radioman30/Radioberry_Pico2/PINI_SI_FIRMWARE.md

# Radioberry RX pe RP2350-PiZero — pini și firmware (stare la 2 oct 2026)

Firmware: `rx_audio` cu **gateware PIO 75.2** (RagchewBerry/WP3DN, citit cu PIO + DMA, 4 linii de date) — 3 oct 2026.
Versiunea veche, pe 8 linii (gateware 73.3): `release/rx_audio_2026-10-03_5730f61.uf2`. Detalii: `PROTOCOL.md` §7.
Fișierul gata de scris pe placă: `release/rx_audio_2026-10-02_e40b5ea.uf2` (local, nu e pe GitHub —
conține gateware-ul PA3GSB/Hermes-Lite2, binar terț).

---

## 1. Cum scrii firmware-ul pe placă

**Varianta simplă (fără programe):**
1. Ține apăsat butonul **BOOT** de pe PiZero și bagă cablul USB în portul USB principal.
2. Dă drumul butonului. Apare un disc nou, **RP2350**.
3. Copiază fișierul `.uf2` pe disc. Placa se repornește singură cu noul firmware.

**Din sursă:** `powershell -File tools\build_rx_audio.ps1 -Flash` (compilează și scrie; găsește singur portul).

După flash, placa apare în Windows ca **port COM12** + **„Microphone (Radioberry RX audio)”**.
Setările salvate (frecvență, mod, filtre, volum, benzi) rămân după reflash cu aceeași versiune.

> Dacă după BOOT Windows nu mai deschide portul COM („device not functioning”): Device Manager →
> șterge dispozitivul USB al plăcii și reconectează (vezi §6).

---

## 2. Header-ul de 40 de pini — ce e legat unde

Radioberry e înfipt direct în header. „Radioberry” = pin folosit de placa radio, nu legi nimic acolo.
GP = numărul GPIO al RP2350 (pe PiZero NU e mereu egal cu BCM).

| Pin | BCM | GP | Folosit de | Ce legi tu |
|---|---|---|---|---|
| 1 | 3V3 | — | alimentare | PCM5102A **VIN**, OLED **VCC** |
| 2, 4 | 5V | — | alimentare Radioberry | — |
| 3 | 2 | **2** | I2C SDA | OLED **SDA** + HAT pin 3 |
| 5 | 3 | **3** | I2C SCL | OLED **SCL** + HAT pin 5 |
| 6, 9, 14, 20, 25, 30, 34, 39 | GND | — | masă | GND PCM5102A, OLED, encoder, butoane, condensator |
| 7 | 4 | **14** | liber cu WM8960 — rezervat TX_CLK (gateware PIO) | (doar rezerva PCM5102A **DIN**) |
| 8 | 14 | **4** | I2S BCLK (intrare, codecul e master) | HAT pin 12 |
| 10 | 15 | **5** | I2S LRCLK (intrare) | HAT pin 35 |
| 11 | 17 | 17 | ieșire FPGA (`pi_cwl`) | **NU LEGA** |
| 12 | 18 | 18 | Radioberry: date RX D0 (PIO) | — |
| 13 | 27 | 27 | Radioberry: nCONFIG | — |
| 15 | 22 | 22 | Radioberry: CONF_DONE | — |
| 16 | 23 | 23 | fost date RX bit 7 — în FPGA doar pull-up slab (test `u`, 21 oct) | WM8960 **ADCDAT** (HAT pin 38) |
| 17 | 3V3 | — | alimentare | ⚠️ chiar lângă pinul 18 — atenție la lipituri |
| **18** | 24 | **24** | Radioberry: DCLK (doar la pornire) | **rețeaua de butoane** prin 470 Ω (§3) |
| 19 | 10 | 11 | Radioberry: SPI MOSI | — |
| 21 | 9 | 12 | Radioberry: SPI MISO | — |
| 22 | 25 | 25 | Radioberry: RDY | — |
| 23 | 11 | 10 | Radioberry: SPI SCLK | — |
| 24 | 8 | 8 | Radioberry: SPI CE0 | — |
| 26 | 7 | 7 | Radioberry: SPI CE1 | — |
| 27 | 0 | **0** | encoder | encoder **A** (CLK) |
| 28 | 1 | **1** | encoder | encoder **B** (DT) |
| 29 | 5 | 15 | Radioberry: TX_DATA (rezervat) | — |
| 31 | 6 | 6 | Radioberry: ceas RX | — |
| 32 | 12 | 9 | Radioberry: TX_RDY (rezervat) | — |
| 33 | 13 | 13 | Radioberry: DATA0 (doar la pornire) | — |
| 35 | 19 | 19 | Radioberry: date RX D1 (PIO) | — |
| 36 | 16 | 16 | fost date RX bit 3 — în FPGA doar pull-up slab (test `u`, 21 oct) | WM8960 **DACDAT** (HAT pin 40) |
| 37 | 26 | 26 | Radioberry: nSTATUS | — |
| 38 | 20 | 20 | Radioberry: date RX D2 (PIO) | — |
| 40 | 21 | 21 | Radioberry: date RX D3 (PIO) | — |

**PCM5102A:** SCK → GND, XSMT → 3V3, FLT/DEMP/FMT → GND. Căștile în mufa modulului.
**Encoder:** comunul la GND. Pinul „+” al modulului **nelegat** (are pull-up-uri de 10 kΩ care încurcă butoanele).

---

## 3. Butoanele — toate pe pinul 18 (GP24)

Pe header nu există pin analogic, așa că butoanele se recunosc după timpul de descărcare al unui
condensator prin rezistența fiecăruia.

```
 pin 18 (GP24) ──[ 470 Ω ]──┬──────────┬──────────┬──────────┐
                            │          │          │          │
                       tantal 1 µF  encoder SW    MOD       BANDA
                       (+ spre nod)    │          │          │
                            │          │       [1 kΩ]    [2,2 kΩ]
                            │          │          │          │
 GND ───────────────────────┴──────────┴──────────┴──────────┘
```

| Buton | Rezistor | Funcție | Timp măsurat pe banc |
|---|---|---|---|
| encoder SW | direct | meniu: parametrul următor; lung = înapoi la FRECV | 0 µs |
| MOD | 1 kΩ | USB → LSB → CW → AM → FM | 600–860 µs |
| BANDA | 2,2 kΩ | scurt = banda următoare, lung = banda anterioară | 2275–3050 µs |
| **PTT (TX)** | 4,7 kΩ | emisie cât e ținut apăsat | 20–26 ms (fereastra PTT: 5–40 ms) |
| (PAS) | 10 kΩ | nefolosit (fereastra lui e acum PTT) | — |

- **470 Ω e obligatoriu**: izolează condensatorul de DCLK la încărcarea FPGA-ului.
- **Modulele de butoane cu pull-up de 10 kΩ** (rezistor spre „+”): rezistorul se scoate sau „+” rămâne nelegat.
- Placa detectează singură rețeaua; pe ecran apare **„RC”** jos-dreapta. Fără ea, pinul 18 e buton simplu.
- Nu ține niciun buton apăsat la pornire.
- Verificare pe USB: `k` (stare + ultimul timp măsurat), `kd` (diagnostic condensator).

---

## 4. Istoricul modificărilor de pini

| Data | Ce s-a schimbat | De ce |
|---|---|---|
| 1 oct | PCM5102A mutat pe **GP4 / GP5 / GP14** (pinii 8 / 10 / 7) | primii pini aleși (GP16 / GP23) sunt linii de date ale Radioberry |
| 1 oct | encoder A/B pe **GP0 / GP1** (pinii 27 / 28), SW pe **GP24** (pinul 18) | singurii pini liberi; DCLK e liber după încărcarea FPGA-ului |
| 1 oct | butonul **BOOT** = banda următoare | header-ul nu mai avea pini |
| 2 oct | butoane **MOD + BANDA pe pinul 18** prin rețea RC (470 Ω, 1 µF, 1 kΩ, 2,2 kΩ); firul SW mutat pe nod | mai multe comenzi fără pini noi |
| 2 oct | scos pull-up-ul de 10 kΩ de pe modulele de butoane | reîncărca condensatorul, toate butoanele păreau „encoder” |
| 2 oct | butonul **BOOT nu mai are funcție** (doar pentru flash) | la cererea ta |
| 2 oct | USB: PID **2E8A:10F1**, portul devine **COM12** (era COM10) | PID-ul vechi (000F) era același cu modul BOOT → Windows încurca driverele |
| 3 oct | **gateware PIO 75.2**: date RX doar pe pinii 12/35/38/40 (GP18–21); pinii 16 și 36 (GP23/GP16) nu mai sunt date | gateware-ul RagchewBerry (WP3DN); cablajul tău rămâne neschimbat |

---

## 5. Ce face firmware-ul

- **Recepție:** USB, LSB, CW, AM, **FM** (bandă îngustă), **SAM** (AM sincron), 10 kHz – 30 MHz, IQ 48 kHz de la FPGA.
- **Squelch** (meniu SQL, oprit sau **+1…+40 dB peste zgomot**): taie căștile până apare semnal; USB-ul rămâne neatins.
  Zgomotul se estimează singur, deci pragul nu mai trebuie refăcut când schimbi câștigul sau banda (de la 3 oct).
  Bun de pornit: +6…+10 dB. Starea (`s`) arată și zgomotul estimat.
  Pe ecran „Q” jos-dreapta, inversat când e închis.
- **Reducere de zgomot** (meniu NR, oprit / 1 / 2 / 3), pe ecran „N”. Simulat: +9 dB (NR1) … +14,5 dB (NR3) SNR.
- **SAM:** PLL pe purtătoare (prinde ±300 Hz în ~20 ms); la fading distorsiunea scade de la -12 dB la -32 dB (simulat).
- Meniul encoderului: FRECV → PAS → MOD → FILTRU → BANDA → VOL → GAIN → **SQL → NR → CAL → DRIVE → MIC → MIC SRC**.
- **Filtre:** SSB 1,8 / 2,0 / 2,5 / 2,7 kHz · CW 250 / 500 / 1000 Hz · AM 6 / 8 kHz · FM 8 / 11 kHz.
- **Benzi** (cu memorie): 160, 80, 60, 49 (AM), 40, 41 (AM), 31 (AM), 30, 20, 17, 15, 12, **CB** (FM), 10 m.
- **Ecran:** frecvență, bandă, mod, S-metru, spectru ±24 kHz, waterfall, meniu jos (pas, volum, câștig, filtru).
- **Setările** se salvează singure în flash la 5 s după ultima schimbare.
- **USB:**
  - **COM12** — comenzi text + **CAT Kenwood TS-2000** (WSJT-X, fldigi, Omni-Rig/HDSDR: 115200, DTR High, PTT None);
  - **microfon „Radioberry RX audio”** — audio demodulat 48 kHz, nivel fix (fără volumul căștilor);
  - **IQ brut** — `python tools/iq_record.py -t 60 -o iq_rec` → WAV pentru HDSDR / SDR# / SDR++.

**Comenzi pe COM12:** `s` stare · `f<Hz>` frecvență · `m<0-5>` mod (5 = SAM) · `v<0-100>` volum · `g<-12..48>` câștig ·
`w<Hz>` filtru · `l<dB>` squelch peste zgomot, 1–40 (`l0` oprit) · `n<0-3>` NR · `c` / `c<ppb>` calibrare · `k` / `kd` butoane · `x` inversează IQ (doar pentru teste; implicit corect = neinversat, verificat cu FT8) · `q1`/`q0` flux IQ · `z<start,stop,pas kHz>` baleiaj.

---

## 6. Probleme cunoscute și soluții

| Simptom | Cauză | Soluție |
|---|---|---|
| COM-ul există dar nu răspunde („device not functioning”) | Windows a legat driverul greșit după BOOT | Device Manager → șterge dispozitivul plăcii → reconectează |
| Toate butoanele fac ce face encoderul | lipsește condensatorul / 470 Ω, sau un pull-up 10 kΩ pe nod | §3; verifică cu `kd` (bun: urcare zeci de ms) |
| Placa nu apare deloc pe USB | scurt la pinul 17 (3V3) lângă 18, tantal invers | verifică lipiturile de lângă pinul 18 |
| Frecvența din WSJT-X nu se schimbă | portul e ocupat de alt program (iq_record, alt terminal) | un singur program pe COM12 odată |

---

## 7. WM8960 Audio HAT — FUNCȚIONAL (21 oct 2026)

**Ce merge:** codec master (PLL din cristalul de 24 MHz → 12,288 MHz; BCLK 1,536 MHz, LRCLK 48 kHz), RP2350 slave
cu program PIO duplex propriu (`wm_pio_start()` în rx_audio.ino) + 2 DMA în inel fără IRQ; difuzoare, căști și
microfoane verificate (48 000 cadre/s, înregistrare microfon fără date pierdute). Driverul: `wm8960.cpp/.h`.
Setările (căști, difuzor, PGA, boost) se salvează în flash (magic RBS4; setările RBS3 se migrează).

**Capcane găsite la punere în funcțiune:**
- Biblioteca I2S din core nu poate fi slave cu intrare aici: cere DIN = BCLK − 1 = GP3 (SCL-ul OLED).
- **SDA blocat după fiecare flash:** Pico se resetează, HAT-ul (5V din header) nu; WM8960 rămâne ținând SDA jos
  → I2C mort, OLED stins. Rezolvat cu `i2c_bus_recover()` la pornire (impulsuri SCL + STOP).
- Pinii I2S ai HAT-ului legați pin-la-pin (ca la un HAT înfipt) cad pe D0–D3 ale Radioberry → IQ stricat.
- **22 oct — I2C instabil intermitent** (SDA ținut la masă de un cip extern, display înghețat, scrieri WM8960 pierdute,
  apărea și dispărea singur; inclusiv cu firmware-ul care mergea pe 21 oct ⇒ hardware). **Rezolvat de user cu un al doilea
  fir de GND între HAT și PiZero + rezistențe pull-up pe SCL/SDA.** Verificat: 16/16 scanări curate, inclusiv după repornire.
  Comanda `o` = model de test pe OLED 15 s (chenar + rândurile 0/2/4/59/61/63).
- Microfonul cu boost +29 dB + PGA +12 dB prinde tot din cameră (fond −26…−33 dBFS); pentru voce: boost +13 dB.
- Comenzile care blocau bucla principală 50 ms dădeau pârâit (rezervă DAC 16 ms) → acum rezervă 62 ms și
  așteptări care pompează audio în continuare.

> **Actualizare 21 oct 2026 (placa a sosit):** cu gateware-ul PIO 75.2 GP16/GP23 sunt libere, deci **DACDAT → GP16
> (pin 36)** și **ADCDAT → GP23 (pin 16)**; varianta GPIO28/USB-C de mai jos e abandonată. GP14 (pin 7) se eliberează
> pentru TX (BCM4 = TX_CLK în gateware-ul PIO). BCK GP4 / LRCK GP5 / I2C GP2-3 rămân. Test `u` (rx_audio, Radioberry
> activ): ambele pini rămân 1 și cu pull-down-ul RP2350, dar trași jos 2 µs la 2 mA cobor și revin în 100–200 ns ⇒
> **pull-up slab (~25 kΩ) al FPGA pe pinii nefolosiți, nu ieșire**. Recomandat 330 Ω în serie pe ambele linii.

Sursă: [wiki Waveshare](https://www.waveshare.com/wiki/WM8960_Audio_HAT), repo clonat local în
`referinte/WM8960-Audio-HAT` (driver Linux = referință pentru registre). HAT-ul: alimentare **5 V**, logică 3,3 V,
cristal **24 MHz** propriu (MCLK), codec **slave** (BCLK/LRCLK vin de la RP2350), I2C **0x1A**, 2 microfoane MEMS,
mufă căști, ieșire difuzor stereo.

**Se leagă cu fire** — nu se înfige peste Radioberry (HAT-ul folosește BCM18–21 = date RX ale Radioberry).
Înlocuiește PCM5102A (aceiași pini I2S).

| Pin pe HAT (format Pi) | Semnal | Se leagă la PiZero | GP |
|---|---|---|---|
| 2 sau 4 | 5V | header pin 2 sau 4 (5V) | — |
| 6 | GND | orice GND | — |
| 3 | SDA | header pin 3 (comun cu OLED) | 2 |
| 5 | SCL | header pin 5 (comun cu OLED) | 3 |
| 12 (BCM18) | BCLK | header pin 8 | 4 |
| 35 (BCM19) | LRCLK | header pin 10 | 5 |
| 40 (BCM21) | DACDAT (spre căști) | header pin 7 | 14 |
| **38 (BCM20)** | **ADCDAT (de la microfon)** | **USB-C secundar, linia D+** (după R8 22 Ω) | **28** |
| 11 (BCM17) | buton HAT | **NU SE LEAGĂ** (pe PiZero e ieșire a FPGA-ului) | — |

**De ce GPIO28:** pe RP2350B un bloc PIO vede GPIO 0–31 *sau* 16–47; I2S-ul folosește deja GP4/5/14, deci intrarea
trebuie să fie sub 32. Din schema PiZero: USB-C secundar (PIO-USB) = **D+ GPIO28 / D− GPIO29** (prin R8/R9 22 Ω);
slotul microSD = GPIO30, 31, 40–43 (40–43 sunt peste 31, nepotrivite); mini-HDMI = GPIO32–39, 44–46.
Acces la GPIO28: un cablu/adaptor USB-C tăiat (D+ = de obicei firul verde) sau direct pe pad-ul lui R8.
USB-C-ul secundar nu mai poate fi folosit ca USB host după asta.

---

## 8. Plănuit: test TX (după WM8960)

- **Sursa audio de emisie:** microfonul WM8960 (ADCDAT pe GPIO28), apoi modulare SSB/CW/AM/FM în RP2350.
- **Calea spre FPGA în gateware 73.x:** eșantioanele TX merg pe **SPI** (commit PA3GSB „73.2 8bits rx + tx spi”),
  probabil pe **CE1 (GP7, pin 26)**, care e deja legat. De extras exact din driverul Pi 4
  (`rb2-tx-stream.c`, `rb2-trx-control.c`) înainte de orice test. Varianta PIO (75.x, Pi 5) ar folosi
  BCM 12/5/4 (TX_RDY/TX_DATA/TX_CLK), ocupați la noi de date RX și I2S, deci nu se potrivește.
- **Siguranță la primul test:** sarcină artificială de 50 Ω, fără amplificator extern, putere minimă
  (comanda de drive), PTT cu timp maxim de emisie în firmware.
- **Gateware:** rămânem pe 73.3 / 73.4. Verificat 3 oct: nici HL2 `gateware/bitfiles` (Radioberry doar 71.3 din 2020;
  74.x e doar pentru plăcile HL2), nici arhiva release `radioberry@rpi5` (dec 2025) nu au ceva mai nou.

---

## 9. Calibrarea frecvenței (făcută 3 oct)

Ceasul Radioberry e decalat cu **+22,96 ppm** (fără corecție: ~220 Hz pe 9,6 MHz, ~330 Hz pe 14 MHz).
Corecția se aplică frecvenței trimise la FPGA; afișajul, CAT-ul și benzile rămân pe frecvența reală. Se salvează.

- **Automat (USB):** pe o stație AM puternică, mod **SAM**, comanda `c` → placa citește decalajul PLL-ului și se
  corectează. Rezultat 3 oct: 9640 kHz -221 Hz → 0…1 Hz; verificat pe 7300 kHz: -4…-8 Hz (fără corecție ~-167 Hz).
- **De pe placă:** meniu **CAL** (după NR): rotire = ±0,1 ppm; în SAM rândul de jos arată decalajul — rotește până ~0 Hz.
- **Manual:** `c<ppb>` (ex. `c22961`), `c0` = fără corecție.

---

## 10. Corectat 3 oct: orientarea spectrului și filtrul SSB

Erau **două erori care se anulau**:
1. IQ-ul de la FPGA era folosit cu Q negat → spectrul (ecran, IQ pentru HDSDR) era în oglindă.
2. Filtrul complex SSB aplica coeficienții de la cel mai vechi eșantion (corelație), deci banda trecută ieșea la −f0:
   filtrul „USB” lăsa LSB (verificat numeric: tonul USB atenuat 74 dB).

Negarea lui Q (pusă pe 1 oct, după ureche) compensa eroarea 2, dar lăsa spectrul și IQ-ul în oglindă. Acum: Q nenegat +
filtrul cu faza corectată. **Verificat obiectiv** cu FT8 pe 60 m, prin tot lanțul (demodulare pe placă → microfon USB →
WSJT-X/jt9): **USB = 7 mesaje decodate într-un interval** (SV3AUW, DK7UY, IK2EST, F5MXH, DG1FK, F6IPR, G0RWF),
**LSB = 0** (contraproba). IQ-ul brut: 16 mesaje fără nicio oglindire. Confirmat la ascultare (3 oct): LSB se aude bine.

---

## 11. WSJT-X (FT8) — configurare verificată 3 oct

File → Settings → **Radio**: Rig **Kenwood TS-2000**, port **COM12**, 115200, Data/Stop **8/1**, Handshake **None**,
Force Control Lines: **DTR High** (RTS nebifat), PTT **VOX**, **Mode: USB** (WSJT-X trece placa pe USB la fiecare
bandă — modurile digitale se lucrează pe USB și pe 40/80 m), Split **None**.
**Audio**: Input **Microphone (Radioberry RX audio)**. Pe placă: filtru **2,7 kHz**. Squelch-ul nu afectează WSJT-X.
Rezultat: decodează FT8 pe 60 m și 40 m, frecvența citită prin CAT.
