radioman30/Radioberry_Pico2/firmware/rb_bringup/rb_bringup.ino

// rb_bringup — firmware de bring-up Radioberry v2 (CL025) pe Raspberry Pi Pico 2
//
// Etapa: verificarea legăturii cu FPGA-ul, fără DSP. Face:
//   1. încarcă gateware-ul (dacă gateware_cl025.h există, vezi tools/make_gateware_header.py)
//   2. citește versiunea gateware-ului pe SPI  -> primul test că SPI-ul merge
//   3. setează 48 kHz, 1 receptor, frecvența RX1
//   4. citește fluxul IQ cu PIO + DMA și verifică marcajele (meta 0 = I, 1 = Q)
//   5. USB: statistici o dată pe secundă; la cerere, IQ brut int16 pentru tools/iq_fft.py
//
// Nucleul 0: FPGA, SPI, IQ, USB.   Nucleul 1: OLED, encoder, butoane.
// Protocolul și pinii: PROTOCOL.md, pins.h.
//
// Comenzi USB (terminal 115200, linie terminată cu Enter):
//   f <Hz>   frecvența RX1          b   flux IQ binar on/off
//   r        reîncarcă FPGA          s   stare
//   d <n>    divizorul PIO RX (implicit 4)

#include <Arduino.h>
#include <Wire.h>
#include <U8g2lib.h>
#include "hardware/pio.h"
#include "hardware/dma.h"
#include "hardware/spi.h"
#include "hardware/gpio.h"
#include "pins.h"

#if __has_include("gateware_cl025.h")
#include "gateware_cl025.h"
#define HAVE_GATEWARE 1
#else
#define HAVE_GATEWARE 0
#endif

// ============================================================
// Stare partajată între nuclee
// ============================================================
static volatile uint32_t g_freq_hz   = 7074000;
static volatile bool     g_freq_dirty = true;     // nucleul 1 cere retrimiterea frecvenței
static volatile bool     g_reload_req = false;
static volatile bool     g_bin_stream = false;
static volatile int      g_fpga_state = 0;        // 0 neîncărcat, 1 OK, -1 eroare, 2 fără gateware
static volatile uint8_t  g_gw_major = 0, g_gw_minor = 0, g_gw_fpga = 0, g_gw_status = 0;
static volatile uint32_t g_words_s = 0, g_pairs_s = 0, g_sync_err_s = 0;
static volatile bool     g_synced = false;
static volatile int32_t  g_last_i = 0, g_last_q = 0;
static volatile uint32_t g_rx_clkdiv = 4;

// ============================================================
// 1. Încărcare gateware — passive serial, LSB primul (rb2-load-fpga.c)
// ============================================================
static inline void dclk_pulse() {
  gpio_put(PIN_FPGA_DCLK, 1);
  __asm volatile("nop\nnop\nnop\nnop\nnop\nnop\nnop\nnop");
  gpio_put(PIN_FPGA_DCLK, 0);
  __asm volatile("nop\nnop\nnop\nnop");
}

// Diagnostic de încărcare, afișat de comanda 'p' și la pornire. Pull-up-urile host-ului fac ca
// nSTATUS/CONF_DONE să citească 1 și fără FPGA; un FPGA alimentat le trage însă la 0 cât timp
// nCONFIG=0 — asta e testul care nu poate fi păcălit.
static int  dg_nstatus_low = -1, dg_confdone_low = -1, dg_confdone_before = -1, dg_confdone_after = -1;
static uint32_t dg_nstatus_rise_us = 0;

static int fpga_load() {
#if !HAVE_GATEWARE
  return 2;
#else
  gpio_set_dir(PIN_FPGA_DATA0, GPIO_OUT);
  gpio_put(PIN_FPGA_NCONFIG, 0);
  gpio_put(PIN_FPGA_DATA0, 0);
  gpio_put(PIN_FPGA_DCLK, 0);
  delay(10);
  dg_nstatus_low  = gpio_get(PIN_FPGA_NSTATUS);    // așteptat 0
  dg_confdone_low = gpio_get(PIN_FPGA_CONFDONE);   // așteptat 0
  gpio_put(PIN_FPGA_NCONFIG, 1);
  uint32_t t0 = micros();
  while (!gpio_get(PIN_FPGA_NSTATUS)) {
    if (micros() - t0 > 2000000) return -1;       // nSTATUS n-a urcat
  }
  dg_nstatus_rise_us = micros() - t0;
  dg_confdone_before = gpio_get(PIN_FPGA_CONFDONE); // așteptat 0 (încă neconfigurat)
  for (uint32_t n = 0; n < GATEWARE_LEN; n++) {
    uint8_t b = GATEWARE[n];
    for (int i = 0; i < 8; i++) {
      gpio_put(PIN_FPGA_DATA0, (b >> i) & 1);
      dclk_pulse();
    }
  }
  dg_confdone_after = gpio_get(PIN_FPGA_CONFDONE);  // așteptat 1
  if (!gpio_get(PIN_FPGA_NSTATUS) || !gpio_get(PIN_FPGA_CONFDONE)) return -1;
  if (dg_nstatus_low != 0 || dg_confdone_before != 0) return -2;   // nimeni nu trage liniile: FPGA absent/nealimentat
  dclk_pulse();                                    // 2 pulsuri de inițializare
  dclk_pulse();
  return 1;
#endif
}

// ============================================================
// 2. Control SPI — 6 octeți: [stare, C0, C1..C4] (protocol HPSDR 1)
//    stare: bit0 running, bit1 CWX, bit2 pa_temp_ok
//    răspuns: [3]&3 = tip FPGA, [4].[5] = versiune gateware
// ============================================================
static const uint8_t RB_STATUS = 0x05;             // running + pa_temp_ok

static void rb_cmd(uint8_t c0, uint32_t data) {
  uint8_t tx[6] = { RB_STATUS, c0, (uint8_t)(data >> 24), (uint8_t)(data >> 16),
                    (uint8_t)(data >> 8), (uint8_t)data };
  uint8_t rx[6];
  gpio_put(PIN_SPI_CE0, 0);
  spi_write_read_blocking(RB_SPI, tx, rx, 6);
  gpio_put(PIN_SPI_CE0, 1);
  g_gw_status = rx[0];
  g_gw_fpga   = rx[3] & 0x03;
  g_gw_major  = rx[4];
  g_gw_minor  = rx[5];
}

// Registrul 0 (C1..C4): 48 kHz (C1[1:0]=0), 1 receptor (C4[5:3]=0), DUPLEX (C4 bit 2) = 1.
// Fără duplex, receptorul 1 urmează frecvența TX, nu pe a lui (protocol HPSDR 1 / Hermes-Lite):
// verificat pe placă — NCO-ul rămânea pe 0 Hz (I = DC constant, Q = 0 exact) până la o comandă TX.
static const uint32_t RB_REG0 = 0x00000004;

static void rb_configure() {
  rb_cmd(0x00, RB_REG0);
  rb_cmd(0x02, g_freq_hz);           // adresa 1: frecvența TX (ținută egală cu RX)
  rb_cmd(0x04, g_freq_hz);           // adresa 2: frecvența RX1
}

// ============================================================
// 3. RX IQ: PIO (programul PA3GSB, rb2-rx-stream.c) + DMA ping-pong
// ============================================================
static const uint16_t rx_iq_program_instr[] = {
  0x000f,  //  0: jmp    15
  0xbb42,  //  1: nop           side 1 [3]
  0x5004,  //  2: in pins, 4    side 0
  0xbb42, 0x5004, 0xbb42, 0x5004, 0xbb42, 0x5004,
  0xbb42, 0x5004, 0xbb42, 0x5004, 0xbb42, 0x5004,   // 3..14: încă 6 nibble-uri
  0xba42,  // 15: nop           side 1 [2]
  0xb242,  // 16: nop           side 0 [2]
  0x00c1,  // 17: jmp pin, 1    (RDY=1 -> citește un cuvânt de 28 biți)
};
static const struct pio_program rx_iq_program = {
  .instructions = rx_iq_program_instr,
  .length = 18,
  .origin = -1,
};

static PIO  rx_pio = pio0;
static uint rx_sm, rx_off;
static int  dma_ch[2];
#define DMA_WORDS 2048
static uint32_t dma_buf[2][DMA_WORDS];
static volatile uint32_t buf_ready_mask = 0;       // bit b = bufferul b e plin
static volatile uint32_t dma_overruns = 0;

static void dma_irq_handler() {
  for (int b = 0; b < 2; b++) {
    if (dma_channel_get_irq1_status(dma_ch[b])) {
      dma_channel_acknowledge_irq1(dma_ch[b]);
      if (buf_ready_mask & (1u << b)) dma_overruns++;  // bufferul nu fusese procesat
      buf_ready_mask |= (1u << b);
      // re-armează canalul terminat (pornește când îl înlănțuie celălalt)
      dma_channel_set_write_addr(dma_ch[b], dma_buf[b], false);
      dma_channel_set_trans_count(dma_ch[b], DMA_WORDS, false);
    }
  }
}

static bool rx_start() {
  if (!pio_can_add_program(rx_pio, &rx_iq_program)) { Serial.println("[RX] PIO: fara loc pt. program"); return false; }
  int sm = pio_claim_unused_sm(rx_pio, false);
  if (sm < 0) { Serial.println("[RX] PIO: niciun state machine liber"); return false; }
  rx_sm  = (uint)sm;
  rx_off = pio_add_program(rx_pio, &rx_iq_program);

  pio_sm_config c = pio_get_default_sm_config();
  sm_config_set_wrap(&c, rx_off + 0, rx_off + 17);
  sm_config_set_sideset(&c, 2, true, false);       // 1 bit + „opt"
  sm_config_set_sideset_pins(&c, PIN_RX_CLK);
  sm_config_set_in_pins(&c, PIN_RX_D0);
  sm_config_set_jmp_pin(&c, PIN_RX_RDY);
  sm_config_set_in_shift(&c, false, true, 28);     // stânga, autopush la 28 biți
  sm_config_set_fifo_join(&c, PIO_FIFO_JOIN_RX);
  sm_config_set_clkdiv_int_frac(&c, g_rx_clkdiv, 0);

  pio_gpio_init(rx_pio, PIN_RX_CLK);
  pio_sm_set_consecutive_pindirs(rx_pio, rx_sm, PIN_RX_CLK, 1, true);
  for (int p = PIN_RX_D0; p <= PIN_RX_D3; p++) { pio_gpio_init(rx_pio, p); gpio_pull_up(p); }
  pio_sm_set_consecutive_pindirs(rx_pio, rx_sm, PIN_RX_D0, 4, false);
  gpio_init(PIN_RX_RDY);
  gpio_set_dir(PIN_RX_RDY, GPIO_IN);
  gpio_pull_up(PIN_RX_RDY);                        // tot ca la PA3GSB

  pio_sm_init(rx_pio, rx_sm, rx_off, &c);

  for (int b = 0; b < 2; b++) {
    dma_ch[b] = dma_claim_unused_channel(false);
    if (dma_ch[b] < 0) { Serial.println("[RX] DMA: niciun canal liber"); return false; }
  }
  for (int b = 0; b < 2; b++) {
    dma_channel_config dc = dma_channel_get_default_config(dma_ch[b]);
    channel_config_set_transfer_data_size(&dc, DMA_SIZE_32);
    channel_config_set_read_increment(&dc, false);
    channel_config_set_write_increment(&dc, true);
    channel_config_set_dreq(&dc, pio_get_dreq(rx_pio, rx_sm, false));
    channel_config_set_chain_to(&dc, dma_ch[b ^ 1]);
    dma_channel_configure(dma_ch[b], &dc, dma_buf[b], &rx_pio->rxf[rx_sm], DMA_WORDS, false);
    dma_channel_set_irq1_enabled(dma_ch[b], true);
  }
  irq_add_shared_handler(DMA_IRQ_1, dma_irq_handler, PICO_SHARED_IRQ_HANDLER_DEFAULT_ORDER_PRIORITY);
  irq_set_enabled(DMA_IRQ_1, true);
  dma_channel_start(dma_ch[0]);
  pio_sm_set_enabled(rx_pio, rx_sm, true);
  return true;
}

// ============================================================
// 4. Procesarea cuvintelor: meta = biții 27..24, eșantion = 23..0 (cu semn)
// ============================================================
static uint32_t cnt_words = 0, cnt_pairs = 0, cnt_sync_err = 0;
static bool synced = false;
static uint8_t expect = 0;
static int32_t cur_i = 0;
static int16_t usb_out[512];
static int usb_n = 0;

static void process_buffer(const uint32_t *w, int n) {
  for (int k = 0; k < n; k++) {
    uint32_t v = w[k];
    uint8_t meta = (v >> 24) & 0x0F;
    int32_t s = (int32_t)(v << 8) >> 8;           // extensie de semn pe 24 biți
    cnt_words++;
    if (!synced) {
      if (meta != 0) continue;
      synced = true;
      expect = 0;
    }
    if (meta != expect) { synced = false; cnt_sync_err++; continue; }
    if (expect == 0) {
      cur_i = s;
    } else {
      cnt_pairs++;
      g_last_i = cur_i;
      g_last_q = s;
      if (g_bin_stream) {
        usb_out[usb_n++] = (int16_t)(cur_i >> 8);
        usb_out[usb_n++] = (int16_t)(s >> 8);
        if (usb_n >= 512) {
          Serial.write((const uint8_t *)usb_out, sizeof(usb_out));
          usb_n = 0;
        }
      }
    }
    expect ^= 1;                                   // 1 receptor: I, Q, I, Q ...
  }
  g_synced = synced;
}


// ============================================================
// 3b. RX clasic (protocolul Pi 4 / gateware Hermes-Lite 2 „radioberry_cl025" 73.3)
//     RDY (BCM25) = FIFO > 256 eșantioane. Un eșantion = 6 octeți (I hi,mid,lo, Q hi,mid,lo),
//     câte un octet pe fiecare front al ceasului RX (BCM6), pe 8 linii:
//     bit 7..0 = BCM 23,20,19,18,16,13,12,5. Ieșirea FPGA e combinațională pe nivelul ceasului.
//     Doar pe RP2350-PiZero (toate liniile pe header).
// ============================================================
#if defined(ARDUINO_WAVESHARE_RP2350_PIZERO)
#define RB_PROTO_CLASSIC 1
static const uint8_t CL_GP[8] = { 23, 20, 19, 18, 16, 13, 9, 15 };   // GP pt BCM 23,20,19,18,16,13,12,5
static uint32_t cl_samples = 0, cl_blocks = 0;
static volatile uint32_t cl_delay_ns = 0;   // pauza dupa fiecare front ('h<ns>')
static inline void cl_wait() { if (cl_delay_ns) busy_wait_at_least_cycles((uint64_t)cl_delay_ns * 150 / 1000); }

static void classic_init() {
  gpio_init(PIN_RX_CLK); gpio_set_dir(PIN_RX_CLK, GPIO_OUT); gpio_put(PIN_RX_CLK, 0);
  gpio_init(PIN_RX_RDY); gpio_set_dir(PIN_RX_RDY, GPIO_IN);
  for (int i = 0; i < 8; i++) { gpio_init(CL_GP[i]); gpio_set_dir(CL_GP[i], GPIO_IN); }
}

static inline uint8_t cl_byte(uint32_t all) {
  return (uint8_t)((((all >> 23) & 1) << 7) | (((all >> 20) & 1) << 6) | (((all >> 19) & 1) << 5) |
                   (((all >> 18) & 1) << 4) | (((all >> 16) & 1) << 3) | (((all >> 13) & 1) << 2) |
                   (((all >>  9) & 1) << 1) |  ((all >> 15) & 1));
}

// citește un bloc de 63 de eșantioane (ca driverul Pi 4) dacă RDY e sus
static void classic_poll() {
  if (!gpio_get(PIN_RX_RDY)) return;
  for (int s = 0; s < 63; s++) {
    uint8_t b[6];
    for (int i = 0; i < 6; i++) {
      gpio_put(PIN_RX_CLK, (i & 1) ? 0 : 1);
      __asm volatile("nop\nnop\nnop\nnop\nnop\nnop\nnop\nnop\nnop\nnop\nnop\nnop");
      cl_wait();
      b[i] = cl_byte(gpio_get_all());
    }
    int32_t I = (int32_t)(((uint32_t)b[0] << 24) | ((uint32_t)b[1] << 16) | ((uint32_t)b[2] << 8)) >> 8;
    int32_t Q = (int32_t)(((uint32_t)b[3] << 24) | ((uint32_t)b[4] << 16) | ((uint32_t)b[5] << 8)) >> 8;
    cnt_words += 2;
    cnt_pairs++;
    g_last_i = I;
    g_last_q = Q;
    if (g_bin_stream) {
      usb_out[usb_n++] = (int16_t)(I >> 8);
      usb_out[usb_n++] = (int16_t)(Q >> 8);
      if (usb_n >= 512) { Serial.write((const uint8_t *)usb_out, sizeof(usb_out)); usb_n = 0; }
    }
  }
  cl_blocks++;
  g_synced = true;
}

// 'k': octeții bruți ai câtorva eșantioane (așteaptă RDY), ca să se vadă formatul
static void classic_dump() {
  uint32_t tw = millis();
  while (!gpio_get(PIN_RX_RDY)) if (millis() - tw > 500) { Serial.println("RDY nu urca"); return; }
  for (int s = 0; s < 8; s++) {
    uint8_t b[6];
    for (int i = 0; i < 6; i++) {
      gpio_put(PIN_RX_CLK, (i & 1) ? 0 : 1);
      __asm volatile("nop\nnop\nnop\nnop\nnop\nnop\nnop\nnop\nnop\nnop\nnop\nnop");
      cl_wait();
      b[i] = cl_byte(gpio_get_all());
    }
    Serial.printf("esantion %d: %02X %02X %02X | %02X %02X %02X\n", s, b[0], b[1], b[2], b[3], b[4], b[5]);
  }
}
#else
#define RB_PROTO_CLASSIC 0
#endif

// ============================================================
// USB: comenzi text
// ============================================================
static char cmd_line[48];
static int cmd_len = 0;

static void print_status() {
  static const char *FPGA_STATE[] = { "neincarcat", "OK", "fara gateware" };
  int st = g_fpga_state;
  Serial.printf("FPGA: %s | gateware %u.%u tip %u stare 0x%02X | RX %lu Hz | div %lu\n",
                st == -2 ? "NU RASPUNDE (alimentare/conectare?)" : st < 0 ? "EROARE" : FPGA_STATE[st],
                g_gw_major, g_gw_minor, g_gw_fpga,
                g_gw_status, (unsigned long)g_freq_hz, (unsigned long)g_rx_clkdiv);
}

static void print_load_diag() {
  Serial.printf("incarcare: cu nCONFIG=0 -> nSTATUS=%d CONF_DONE=%d (asteptat 0 0) | "
                "nSTATUS urca dupa %lu us | CONF_DONE inainte=%d dupa=%d (asteptat 0 -> 1)\n",
                dg_nstatus_low, dg_confdone_low, (unsigned long)dg_nstatus_rise_us,
                dg_confdone_before, dg_confdone_after);
  if (dg_nstatus_low == 1 && dg_confdone_low == 1)
    Serial.println("  => liniile NU coboara: FPGA nealimentat / neconectat / alti pini");
}

static void print_pins() {
  Serial.printf("pini: nSTATUS=%d CONF_DONE=%d nCONFIG=%d | RDY=%d D3..D0=%d%d%d%d | MISO=%d\n",
                gpio_get(PIN_FPGA_NSTATUS), gpio_get(PIN_FPGA_CONFDONE), gpio_get(PIN_FPGA_NCONFIG),
                gpio_get(PIN_RX_RDY), gpio_get(PIN_RX_D3), gpio_get(PIN_RX_D2), gpio_get(PIN_RX_D1),
                gpio_get(PIN_RX_D0), gpio_get(PIN_SPI_MISO));
}

static void spi_probe() {
  for (int k = 0; k < 5; k++) {
    uint8_t tx[6] = { RB_STATUS, 0x00, 0, 0, 0, (uint8_t)RB_REG0 }, rx[6];
    gpio_put(PIN_SPI_CE0, 0);
    spi_write_read_blocking(RB_SPI, tx, rx, 6);
    gpio_put(PIN_SPI_CE0, 1);
    Serial.printf("SPI %d: %02X %02X %02X %02X %02X %02X\n", k, rx[0], rx[1], rx[2], rx[3], rx[4], rx[5]);
    delay(20);
  }
}

static void dump_words() {
  // copie din bufferul DMA curent (instantaneu, fără sincronizare - doar pentru inspecție)
  Serial.print("cuvinte RX (meta|esantion): ");
  for (int k = 0; k < 16; k++) {
    uint32_t v = dma_buf[0][k];
    Serial.printf("%X|%06lX ", (unsigned)((v >> 24) & 0xF), (unsigned long)(v & 0xFFFFFF));
  }
  Serial.println();
}

// Test SPI amănunțit: 4 moduri × 2 viteze pe perifericul hardware, apoi bit-bang mod 3,
// cu MISO pe pull-up ca să se vadă dacă FPGA-ul comandă linia deloc.
static uint8_t bb_xfer_mode3(uint8_t out) {
  uint8_t in = 0;
  for (int i = 7; i >= 0; i--) {
    gpio_put(PIN_SPI_SCK, 0);                       // mod 3: front coborâtor = scriere
    gpio_put(PIN_SPI_MOSI, (out >> i) & 1);
    delayMicroseconds(5);
    gpio_put(PIN_SPI_SCK, 1);                       // front urcător = citire
    delayMicroseconds(5);
    in = (in << 1) | gpio_get(PIN_SPI_MISO);
  }
  return in;
}

static void spi_deep_probe() {
  gpio_pull_up(PIN_SPI_MISO);
  delay(2);
  Serial.printf("MISO cu CS sus (pull-up): %d\n", gpio_get(PIN_SPI_MISO));
  gpio_put(PIN_SPI_CE0, 0); delay(2);
  Serial.printf("MISO cu CS jos (pull-up): %d\n", gpio_get(PIN_SPI_MISO));
  gpio_put(PIN_SPI_CE0, 1);

  static const spi_cpol_t POL[4] = { SPI_CPOL_0, SPI_CPOL_0, SPI_CPOL_1, SPI_CPOL_1 };
  static const spi_cpha_t PHA[4] = { SPI_CPHA_0, SPI_CPHA_1, SPI_CPHA_0, SPI_CPHA_1 };
  static const uint32_t HZ[2] = { 100000, 4000000 };
  for (int m = 0; m < 4; m++) for (int h = 0; h < 2; h++) {
    spi_set_baudrate(RB_SPI, HZ[h]);
    spi_set_format(RB_SPI, 8, POL[m], PHA[m], SPI_MSB_FIRST);
    uint8_t tx[6] = { RB_STATUS, 0x00, 0, 0, 0, 0 }, rx[6];
    gpio_put(PIN_SPI_CE0, 0);
    spi_write_read_blocking(RB_SPI, tx, rx, 6);
    gpio_put(PIN_SPI_CE0, 1);
    Serial.printf("hw mod %d %7lu Hz: %02X %02X %02X %02X %02X %02X\n", m, (unsigned long)HZ[h],
                  rx[0], rx[1], rx[2], rx[3], rx[4], rx[5]);
    delay(5);
  }
  // bit-bang mod 3
  gpio_set_function(PIN_SPI_SCK, GPIO_FUNC_SIO);  gpio_set_dir(PIN_SPI_SCK, GPIO_OUT);  gpio_put(PIN_SPI_SCK, 1);
  gpio_set_function(PIN_SPI_MOSI, GPIO_FUNC_SIO); gpio_set_dir(PIN_SPI_MOSI, GPIO_OUT);
  gpio_set_function(PIN_SPI_MISO, GPIO_FUNC_SIO); gpio_set_dir(PIN_SPI_MISO, GPIO_IN);
  uint8_t tx[6] = { RB_STATUS, 0x00, 0, 0, 0, 0 }, rx[6];
  gpio_put(PIN_SPI_CE0, 0); delayMicroseconds(10);
  for (int k = 0; k < 6; k++) rx[k] = bb_xfer_mode3(tx[k]);
  gpio_put(PIN_SPI_SCK, 1); delayMicroseconds(10);
  gpio_put(PIN_SPI_CE0, 1);
  Serial.printf("bit-bang mod 3:      %02X %02X %02X %02X %02X %02X\n", rx[0], rx[1], rx[2], rx[3], rx[4], rx[5]);
  // înapoi la perifericul hardware, mod 3, 1 MHz
  gpio_set_function(PIN_SPI_MISO, GPIO_FUNC_SPI);
  gpio_set_function(PIN_SPI_SCK,  GPIO_FUNC_SPI);
  gpio_set_function(PIN_SPI_MOSI, GPIO_FUNC_SPI);
  spi_set_baudrate(RB_SPI, 1000000);
  spi_set_format(RB_SPI, 8, SPI_CPOL_1, SPI_CPHA_1, SPI_MSB_FIRST);
}

// Test „gpio-mode" (ca în driverul PA3GSB SBC/rpi-5/archive/gpio-mode): RDY=1 -> 6 octeți,
// fiecare citit pe 8 linii BCM 23,20,19,18,16,13,12,5 (bit 7..0), ceasul RX (BCM6) comutat de mână.
// Doar pe RP2350-PiZero (Radioberry înfipt, toate liniile pe header).
#if defined(ARDUINO_WAVESHARE_RP2350_PIZERO)
static const int GM_PINS[8] = { 23, 20, 19, 18, 16, 13, 9, 15 };   // GP pentru BCM 23,20,19,18,16,13,12,5
static void gpio_mode_test() {
  pio_sm_set_enabled(rx_pio, rx_sm, false);
  gpio_init(PIN_RX_CLK); gpio_set_dir(PIN_RX_CLK, GPIO_OUT); gpio_put(PIN_RX_CLK, 0);
  for (int i = 0; i < 8; i++) { gpio_init(GM_PINS[i]); gpio_set_dir(GM_PINS[i], GPIO_IN); }
  for (int p = PIN_RX_D0; p <= PIN_RX_D3; p++) gpio_init(p), gpio_set_dir(p, GPIO_IN);
  // cât de des urcă RDY în 100 ms
  uint32_t rises = 0, t0 = millis(); int last = gpio_get(PIN_RX_RDY);
  while (millis() - t0 < 100) { int v = gpio_get(PIN_RX_RDY); if (v && !last) rises++; last = v; }
  Serial.printf("RDY: %lu fronturi in 100 ms (cu ceasul oprit)\n", (unsigned long)rises);
  for (int smp = 0; smp < 8; smp++) {
    uint32_t tw = micros();
    while (!gpio_get(PIN_RX_RDY)) if (micros() - tw > 200000) { Serial.println("RDY nu urca (200 ms)"); goto done; }
    uint8_t b[6];
    for (int i = 0; i < 6; i++) {
      gpio_put(PIN_RX_CLK, (i % 2 == 0) ? 1 : 0);
      delayMicroseconds(1);
      uint8_t v = 0;
      for (int k = 0; k < 8; k++) v |= gpio_get(GM_PINS[k]) << (7 - k);
      b[i] = v;
    }
    Serial.printf("esantion %d: %02X %02X %02X  %02X %02X %02X\n", smp, b[0], b[1], b[2], b[3], b[4], b[5]);
  }
done:
  // înapoi la PIO
  pio_gpio_init(rx_pio, PIN_RX_CLK);
  for (int p = PIN_RX_D0; p <= PIN_RX_D3; p++) pio_gpio_init(rx_pio, p);
  pio_sm_set_enabled(rx_pio, rx_sm, true);
}
#else
static void gpio_mode_test() { Serial.println("testul g e doar pentru RP2350-PiZero"); }
#endif

static void handle_command(const char *s) {
#if RB_PROTO_CLASSIC
  if (s[0] == 'k') { classic_dump(); return; }
  if (s[0] == 'h') { cl_delay_ns = strtoul(s + 1, nullptr, 10); Serial.printf("pauza front RX: %lu ns\n", (unsigned long)cl_delay_ns); return; }
#endif
  if (s[0] == 'g') { gpio_mode_test(); return; }
  if (s[0] == 'x') { spi_deep_probe(); return; }
  if (s[0] == 'p') { print_pins(); print_load_diag(); return; }
  if (s[0] == 'w') { dump_words(); return; }
  if (s[0] == 'v') { spi_probe(); return; }
  if (s[0] == 'f') { g_freq_hz = strtoul(s + 1, nullptr, 10); g_freq_dirty = true; }
  else if (s[0] == 'b') { g_bin_stream = !g_bin_stream; usb_n = 0; }
  else if (s[0] == 'r') { g_reload_req = true; }
  else if (s[0] == 'd') {
    uint32_t d = strtoul(s + 1, nullptr, 10);
    if (d >= 1 && d <= 255) { g_rx_clkdiv = d; pio_sm_set_clkdiv_int_frac(rx_pio, rx_sm, d, 0); }
  }
  if (!g_bin_stream) print_status();
}

static void poll_usb_commands() {
  while (Serial.available()) {
    char c = Serial.read();
    if (c == '\r' || c == '\n') {
      if (cmd_len) { cmd_line[cmd_len] = 0; handle_command(cmd_line); cmd_len = 0; }
    } else if (cmd_len < (int)sizeof(cmd_line) - 1) {
      cmd_line[cmd_len++] = c;
    }
  }
}

static void do_fpga_bringup() {
  g_fpga_state = fpga_load();
  // Logica din FPGA rămâne în reset până se blochează PLL-ul. Contorul de biți al slave-ului SPI
  // (48 biți/cadru) NU se resetează la CS sus, doar la reset: un cadru trimis exact când resetul se
  // eliberează rămâne trunchiat și decalează toate cadrele următoare. Deci: așteaptă ieșirea din reset.
  if (g_fpga_state == 1) {
    gpio_set_dir(PIN_FPGA_DATA0, GPIO_IN);         // BCM13: în gpio-mode e ieșire de date a FPGA-ului
    delay(200);
  }
  if (g_fpga_state == 1 || g_fpga_state == 2) rb_configure();
}

// ============================================================
// Nucleul 0
// ============================================================
void setup() {
  Serial.begin(115200);
  uint32_t t_usb = millis();
  while (!Serial && millis() - t_usb < 3000) delay(10);   // lasă timp terminalului
  Serial.printf("\nrb_bringup pe %s\n", RB_BOARD_NAME);

  gpio_init(PIN_FPGA_NCONFIG);  gpio_set_dir(PIN_FPGA_NCONFIG, GPIO_OUT); gpio_put(PIN_FPGA_NCONFIG, 1);
  gpio_init(PIN_FPGA_DATA0);    gpio_set_dir(PIN_FPGA_DATA0, GPIO_OUT);
  gpio_init(PIN_FPGA_DCLK);     gpio_set_dir(PIN_FPGA_DCLK, GPIO_OUT);
  // pull-up ca în driverul PA3GSB (pad 0xC8 = intrare + pull-up pe RP1): nSTATUS și CONF_DONE
  // sunt open-drain la FPGA, iar Radioberry se bazează pe pull-up-ul host-ului
  gpio_init(PIN_FPGA_NSTATUS);  gpio_set_dir(PIN_FPGA_NSTATUS, GPIO_IN);  gpio_pull_up(PIN_FPGA_NSTATUS);
  gpio_init(PIN_FPGA_CONFDONE); gpio_set_dir(PIN_FPGA_CONFDONE, GPIO_IN); gpio_pull_up(PIN_FPGA_CONFDONE);

  spi_init(RB_SPI, 1000000);                         // 1 MHz la început (PA3GSB: 10 MHz)
  // mod SPI 3 (CPOL=1, CPHA=1) — din radioberry.dts al PA3GSB (spi-mode = <3>, max 48 MHz)
  spi_set_format(RB_SPI, 8, SPI_CPOL_1, SPI_CPHA_1, SPI_MSB_FIRST);
  gpio_set_function(PIN_SPI_MISO, GPIO_FUNC_SPI);
  gpio_set_function(PIN_SPI_SCK,  GPIO_FUNC_SPI);
  gpio_set_function(PIN_SPI_MOSI, GPIO_FUNC_SPI);
  gpio_init(PIN_SPI_CE0); gpio_set_dir(PIN_SPI_CE0, GPIO_OUT); gpio_put(PIN_SPI_CE0, 1);
  gpio_init(PIN_SPI_CE1); gpio_set_dir(PIN_SPI_CE1, GPIO_OUT); gpio_put(PIN_SPI_CE1, 1);

  // Ceasul RX pe nivel jos ÎNAINTE de încărcare: gateware-ul numără separat fronturile urcătoare
  // (up) și coborâtoare (down); un front coborâtor în plus după reset (pin flotant sus -> jos)
  // decalează contoarele și registrul I nu se mai încarcă niciodată (octeții 3-5 rămân 0).
  gpio_init(PIN_RX_CLK); gpio_set_dir(PIN_RX_CLK, GPIO_OUT); gpio_put(PIN_RX_CLK, 0);
  Serial.println("[1] FPGA: incarc gateware...");
  do_fpga_bringup();
  Serial.printf("[1] FPGA: stare %d (1=OK, -1=eroare: nSTATUS/CONF_DONE, 2=fara gateware)\n", g_fpga_state);
  print_pins();
  print_load_diag();
  g_freq_dirty = false;
#if RB_PROTO_CLASSIC
  Serial.println("[2] RX: protocol clasic Pi 4 (8 linii, gateware HL2 radioberry_cl025)");
  classic_init();
#else
  Serial.println("[2] RX: pornesc PIO + DMA...");
  Serial.println(rx_start() ? "[2] RX: pornit" : "[2] RX: EROARE");
#endif
  print_status();
}

void loop() {
  static uint32_t t_stat = 0, t_keepalive = 0;
  static uint8_t keep_idx = 0;

#if RB_PROTO_CLASSIC
  if (g_fpga_state == 1) classic_poll();
#endif
  // buffere DMA pline
  for (int b = 0; b < 2; b++) {
    if (buf_ready_mask & (1u << b)) {
      process_buffer(dma_buf[b], DMA_WORDS);
      noInterrupts(); buf_ready_mask &= ~(1u << b); interrupts();
    }
  }

  poll_usb_commands();

  if (g_reload_req) { g_reload_req = false; do_fpga_bringup(); }
  if (g_freq_dirty) { g_freq_dirty = false; rb_cmd(0x02, g_freq_hz); rb_cmd(0x04, g_freq_hz); }

  // comenzile se retrimit ciclic, ca în firmware-ul PA3GSB (una per pachet RX)
  uint32_t now = millis();
  if (now - t_keepalive >= 100 && g_fpga_state > 0) {
    t_keepalive = now;
    // retrimise ciclic toate trei: reg 0 (cu duplex), TX, RX1
    if (keep_idx == 0) rb_cmd(0x00, RB_REG0); else if (keep_idx == 1) rb_cmd(0x02, g_freq_hz); else rb_cmd(0x04, g_freq_hz);
    keep_idx = (keep_idx + 1) % 3;
  }

  if (now - t_stat >= 1000) {
    t_stat = now;
    g_words_s = cnt_words; g_pairs_s = cnt_pairs; g_sync_err_s = cnt_sync_err;
    cnt_words = cnt_pairs = cnt_sync_err = 0;
    if (!g_bin_stream) {
      Serial.printf("cuvinte/s %lu | perechi IQ/s %lu | erori sync %lu | overrun %lu | %s | I %ld Q %ld\n",
                    (unsigned long)g_words_s, (unsigned long)g_pairs_s, (unsigned long)g_sync_err_s,
                    (unsigned long)dma_overruns, g_synced ? "SYNC" : "fara sync",
                    (long)g_last_i, (long)g_last_q);
    }
  }
}

// ============================================================
// Nucleul 1: OLED + encoder + butoane
// ============================================================
U8G2_SH1106_128X64_NONAME_F_2ND_HW_I2C oled(U8G2_R0, U8X8_PIN_NONE);

static volatile int32_t enc_delta = 0;
static const uint32_t STEPS[] = { 10, 100, 1000, 10000, 100000 };
static int step_idx = 2;

static void enc_isr() {
  static uint8_t prev = 0;
  static int8_t acc = 0;
  static const int8_t TAB[16] = { 0, -1, 1, 0, 1, 0, 0, -1, -1, 0, 0, 1, 0, 1, -1, 0 };
  uint8_t cur = (gpio_get(PIN_ENC_A) << 1) | gpio_get(PIN_ENC_B);
  acc += TAB[(prev << 2) | cur];
  prev = cur;
  if (acc >= 4)  { enc_delta++; acc = 0; }        // un pas = un ciclu complet (4 tranziții)
  if (acc <= -4) { enc_delta--; acc = 0; }
}

static bool button_pressed(int pin, uint32_t &t_last, bool &was_down) {
  bool down = !digitalRead(pin);
  uint32_t now = millis();
  bool edge = false;
  if (down && !was_down && now - t_last > 30) { edge = true; t_last = now; }
  if (down != was_down) was_down = down;
  return edge;
}


// Apăsare encoder: 1 = scurtă, 2 = lungă (>700 ms). Lunga ține locul BUTONULUI 2 pe plăcile
// fără el (RP2350-PiZero: doar 4 pini liberi pentru UI).
static int enc_sw_event() {
  static bool down = false, long_sent = false;
  static uint32_t t_down = 0;
  bool now_down = !digitalRead(PIN_ENC_SW);
  uint32_t t = millis();
  int ev = 0;
  if (now_down && !down) { t_down = t; long_sent = false; }
  if (now_down && !long_sent && t - t_down > 700) { ev = 2; long_sent = true; }
  if (!now_down && down && !long_sent && t - t_down > 30) ev = 1;
  down = now_down;
  return ev;
}

void setup1() {
  static const int UI_PINS[] = { PIN_ENC_A, PIN_ENC_B, PIN_ENC_SW, PIN_BTN1, PIN_BTN2 };
  for (int p : UI_PINS) if (p >= 0) pinMode(p, INPUT_PULLUP);
  attachInterrupt(digitalPinToInterrupt(PIN_ENC_A), enc_isr, CHANGE);
  attachInterrupt(digitalPinToInterrupt(PIN_ENC_B), enc_isr, CHANGE);

  Wire1.setSDA(PIN_OLED_SDA);
  Wire1.setSCL(PIN_OLED_SCL);
  Wire1.setClock(400000);
  oled.begin();
}

void loop1() {
  static uint32_t t_draw = 0, t_b1 = 0, t_b2 = 0;
  static bool b1_d = false, b2_d = false;

  int32_t d;
  noInterrupts(); d = enc_delta; enc_delta = 0; interrupts();
  if (d) {
    int64_t f = (int64_t)g_freq_hz + (int64_t)d * STEPS[step_idx];
    if (f < 10000) f = 10000;
    if (f > 30000000) f = 30000000;
    g_freq_hz = (uint32_t)f;
    g_freq_dirty = true;
  }
  int sw = enc_sw_event();
  if (sw == 1) step_idx = (step_idx + 1) % 5;
  if (button_pressed(PIN_BTN1, t_b1, b1_d))   g_bin_stream = !g_bin_stream;
  if ((PIN_BTN2 >= 0 && button_pressed(PIN_BTN2, t_b2, b2_d)) || (PIN_BTN2 < 0 && sw == 2))
    g_reload_req = true;

  uint32_t now = millis();
  if (now - t_draw < 200) return;
  t_draw = now;

  char l[24];
  oled.clearBuffer();
  oled.setFont(u8g2_font_10x20_tf);
  uint32_t f = g_freq_hz;
  snprintf(l, sizeof(l), "%2lu.%03lu.%02lu", (unsigned long)(f / 1000000),
           (unsigned long)(f / 1000 % 1000), (unsigned long)(f % 1000 / 10));
  oled.drawStr(0, 18, l);
  oled.setFont(u8g2_font_6x10_tf);
  snprintf(l, sizeof(l), "pas %lu Hz", (unsigned long)STEPS[step_idx]);
  oled.drawStr(0, 32, l);
  int st = g_fpga_state;
  snprintf(l, sizeof(l), "FPGA %s gw %u.%u", st == 1 ? "OK" : st == 2 ? "lipsa" : st == -2 ? "NU RASP" : st < 0 ? "ERR" : "-",
           g_gw_major, g_gw_minor);
  oled.drawStr(0, 44, l);
  snprintf(l, sizeof(l), "%lu IQ/s %s", (unsigned long)g_pairs_s, g_synced ? "SYNC" : "nosync");
  oled.drawStr(0, 54, l);
  snprintf(l, sizeof(l), "err %lu%s", (unsigned long)g_sync_err_s, g_bin_stream ? "  USB-IQ" : "");
  oled.drawStr(0, 64, l);
  oled.sendBuffer();
}
