radioman30/Radioberry_Pico2/(commit log)

2026-09-30 PROTOCOL.md: interfata host<->FPGA din driverul PA3GSB Pi 5 pio-mode (IQ pe PIO, nu SPI)
2026-09-30 Firmware bring-up rb_bringup (Pico 2): FPGA load, SPI control, RX IQ prin PIO+DMA, OLED/encoder/butoane; harta de pini v2; iq_fft.py
    Compilat cu arduino-pico 5.5.1 (rpipico2): 83 KB flash, 29 KB RAM. Netestat pe placa.
2026-09-30 WIRING §0.3: maparea header->GPIO pe RP2350-PiZero din RP2350-SDR-CW-Interface (PA3GSB); SPI pe SPI1 hardware
2026-09-30 README 3.1: lantul audio cu Teensy 3.6 + Audio Shield ca etaj DSP extern (atenuare -6 dB)
2026-09-30 Teensy 3.6 + Audio Shield = placa de sunet a lui Pico (I2S audio, I2C comenzi); PCM5102A scos
2026-09-30 README: diagrama de arhitectura cu Teensy ca placa de sunet
2026-10-01 firmware/audio_test: test PCM5102A (ton stereo/L/R, baleiaj, CW, liniste) + OLED/encoder/butoane
    Compilat arduino-pico 5.5.1 (rpipico2): 93 KB flash. Netestat pe placa.
2026-10-01 pins.h pentru Pico 2 si RP2350-PiZero (mapare din schema Waveshare); SPI1 pe PiZero; buton 2 = apasare lunga encoder pe PiZero
    Compilat fara avertismente pe ambele placi (audio_test + rb_bringup).
2026-10-01 rb_bringup: fix panic la pornire (DMA_IRQ_0 exclusiv vs Wire partajat -> DMA_IRQ_1 partajat); erori raportate pe USB; jurnal de pornire; pull-down nSTATUS/CONF_DONE
    [rb_bringup.ino]
2026-10-01 rb_bringup: SPI mod 3 (din radioberry.dts PA3GSB); diagnostic incarcare FPGA (nSTATUS/CONF_DONE trase la 0 de FPGA); comenzi p/v/w/x (pini, versiune, cuvinte RX, test SPI complet); pull-up pe intrari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
    Pe placa (RP2350-PiZero + Radioberry CL025): gateware-ul se incarca (CONF_DONE 0->1, nSTATUS
    urca dupa ~60 us), FPGA-ul comanda MISO cand CS e jos, dar raspunde doar cu zerouri in toate
    modurile SPI -> suspect: lipsa ceasului intern FPGA (oscilator/AD9866), probabil alimentare.
2026-10-01 rb_bringup: asteptare 200 ms dupa incarcare (cadre SPI de 48 biti nealiniate la iesirea din reset); DATA0 intrare dupa config; test 'g' citire stil gpio-mode (8 linii, ceas manual)
    Pe placa: RDY nu urca deloc (nici cu ceasul oprit, nici gpio-mode) -> receptorul din gateware nu produce
    esantioane; SPI raspunde 0 (in gateware-ul Tinkerboard raspunsul de control e 0 prin constructie).
    [rb_bringup.ino]
2026-10-01 RECEPTIE FUNCTIONALA: gateware Hermes-Lite 2 radioberry_cl025 73.3 + protocol clasic Pi 4 pe RP2350-PiZero
    48006 perechi IQ/s, I/Q zgomot real, versiune 73.3 pe SPI. Cauze gasite:
    - gateware-ul din arhiva rpi-5 PA3GSB nu e perechea driverului pio (SPI 0, RDY mort)
    - registrul 0 fara DUPLEX -> RX1 urmeaza frecventa TX -> NCO 0 Hz (I=DC, Q=0)
    - ceasul RX trebuie tinut jos inainte de incarcare (contoare up/down decalate)
    - prima comanda SPI abia dupa iesirea din reset (cadre de 48 biti)
    Comenzi noi: k (octeti bruti), h<ns> (pauza front RX). PROTOCOL.md §6.
    [rb_bringup.ino]
2026-10-01 firmware/rx_audio: receptor SSB/CW/AM pe RP2350-PiZero + Radioberry (protocol clasic, gateware HL2 73.3)
    IQ 48 kHz -> decimare /4 (FIR 41) -> filtru complex trece-banda 127 tapuri la 12 kHz
    (USB 250-2850, LSB, CW 700+-250, AM +-4k) -> demod (Re / anvelopa) -> AGC -> PCM5102A I2S 12 kHz.
    Pini noi pe header liberi de FPGA (netlist Radioberry.net): I2S BCK hdr8/LRCK hdr10/DIN hdr7,
    OLED hdr3/5, encoder A hdr27 B hdr28 SW hdr18 (DCLK dupa configurare). BCM17/21 = iesiri FPGA, interzise.
    Perechea IQ: Q din cadrul n cu I din cadrul n-1. Compilat, netestat pe placa.
2026-10-01 WIRING §0.5: header complet PiZero + Radioberry + rx_audio (din netlist Radioberry)
2026-10-01 rx_audio: castig RX (adresa 0x0A, implicit +20 dB, comanda g<dB>); fara el LNA-ul ramanea pe -12 dB
    Masurat pe placa: S-metrul urca 1:1 cu castigul (-12 dB: -109,5 dBFS ... +36 dB: -62,6 dBFS).
2026-10-01 rx_audio: SE AUDE STATIA (AM 9,940 MHz) - receptor complet pe RP2350-PiZero + Radioberry
    - iesire audio 48 kHz (interpolare x4 din 12 kHz), ca audio_test validat
    - meniu cu un buton: scurt = parametrul urmator (acord/pas/mod/volum/castig), lung sau 6 s = acord
    - castig RX reglabil din meniu si cu g<dB>
    - z<start,stop,pas> baleiaj S-metru (a gasit 9,940 MHz la ~35 dB peste zgomot)
    - i: activitatea pinilor audio (a aratat ca semnalele I2S ies corect; problema era la fire)
    [rx_audio.ino]
2026-10-01 rx_audio: setarile se salveaza in flash (EEPROM) la 5 s dupa ultima schimbare si se reincarca la pornire
2026-10-01 rx_audio: 4 butoane (MOD, BANDA, FILTRU, PAS) pe GP24 prin retea RC, detectata automat; WIRING §0.6
2026-10-01 rx_audio: redetectare retea butoane la 5 s + indicator RC pe ecran
2026-10-01 rx_audio: scos butonul BOOT ca schimbare de banda (la cerere)
2026-10-01 rx_audio: limite butoane recalibrate pe masuratori reale, log la fiecare apasare, diagnostic kd; WIRING: capcana pull-up 10k pe module
2026-10-01 rx_audio: mod FM (NBFM, discriminator + de-accentuare, filtre 8/11 kHz), banda CB; setari RBS2
2026-10-01 rx_audio: flux IQ pe USB (q1/q0) + tools/iq_record.py -> WAV pentru HDSDR; FIX perechea I/Q = acelasi cadru (imaginile scad la nivelul zgomotului)
    [iq_record.py, rx_audio.ino]
2026-10-01 rx_audio: microfon USB (UAC2 48 kHz) cu audio demodulat, stiva Adafruit TinyUSB, PID 10F1; tools/build_rx_audio.ps1; iq_record gaseste singur portul
2026-10-02 PINI_SI_FIRMWARE.md: cablaj complet, istoricul modificarilor de pini, flash UF2, functii; release/ ignorat (UF2 contine gateware tert)
2026-10-02 FIX orientare spectru: fara negarea lui Q (USB = frecvente pozitive), verificat prin decodare FT8 (jt9) pe 60 m: 16 mesaje; inainte USB/LSB erau inversate
    [rx_audio.ino]
2026-10-02 FIX filtrul SSB: faza coeficientilor inversata (buffer de la cel mai vechi esantion) - compensa gresit negarea lui Q; verificat FT8 prin microfonul USB: USB 7 decodari, LSB 0
    [rx_audio.ino]
2026-10-02 PINI_SI_FIRMWARE: LSB confirmat la ascultare
2026-10-02 rx_audio: calibrare frecventa (ppb, salvata): automat din SAM (comanda c), meniu CAL, manual c<ppb>; calibrat +22.96 ppm, verificat 9640 si 7300 kHz
2026-10-04 README rescris: doar funcții, placa de sunet, pini, comenzi, USB/CAT, compilare (model RagchewBerry); planul vechi mutat în docs/JURNAL_PROIECTARE.md
2026-10-04 rx_audio pe gateware PIO 75.2 (RagchewBerry, 4 linii PIO+DMA), squelch relativ la zgomot, rb_bringup_pio; docs actualizate
2026-10-21 WM8960 Audio HAT: codec master, PIO duplex slave, difuzoare/căști/microfoane
    - wm8960.cpp/.h: PLL din cristalul de 24 MHz (12,288 MHz), I2S master 48 kHz,
    DAC -> căști/difuzor, LINPUT1/RINPUT1 -> ADC; volume și câștig microfon
    - rx_audio: program PIO duplex propriu (DACDAT GP16, ADCDAT GP23, BCLK/LRCLK
    intrări pe GP4/GP5), 2 DMA în inel fără IRQ, rezervă DAC 62 ms;
    fallback automat pe PCM5102A dacă 0x1A nu răspunde
    - I2C doar de pe nucleul 1; deblocare SDA la pornire (WM8960 rămânea cu SDA
    jos după fiecare flash)
    - setări WM8960 în flash (RBS4, migrare din RBS3)
    - comenzi a/ah/as/am/ab/al/au/ai/ar, test u pentru GP16/GP23
    - documentație: cablaj HAT (README, WIRING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
2026-10-21 WIP: TX (PIO + DMA, TUNE/mic SSB/AM, PTT BOOT/RC/CAT) + diagnostic I2C
    Netestat complet: magistrala I2C (OLED + WM8960) devine instabilă după
    pornirea codecului ca master (bănuială: diafonie BCLK -> SDA/SCL pe fire).
    TUNE 1 kHz verificat: 48000 cuvinte/s, RX propriu +1 kHz cu 30 dB peste imagine.
2026-10-21 OLED: comanda o (model de test 15 s); docs: I2C instabil rezolvat cu GND suplimentar + pull-up-uri
2026-10-21 TX: inel DMA 32 KB (maximul hardware, 64 KB oprea DMA-ul), rezervă 5000; I2C înapoi la 400 kHz
    - cu TX_RING_BITS 16 câmpul RING_SIZE (4 biți) se dezactiva, DMA-ul citea liniar
    până la capătul RAM-ului și se oprea după 0,4-2 s; static_assert pe toate inelele
    - verificat pe 50 Ω: TUNE și microfon SSB câte 8 s, 48 000 eșantioane/s, 0 sub / 0 peste
    - PTT pe butonul de 4,7 kΩ (20-26 ms) verificat de user: pornește/oprește emisia
2026-10-21 TX: DRIVE și MIC în meniu (salvate), fără limită de timp, emisie 1,5-30 MHz
    - meniu: ... CAL > DRIVE (0-15, bară) > MIC (PGA codec, 1,5 dB/pas, vârful vocii în emisie)
    - drive în setări (rsv[0] = drive+1, fără schimbarea structurii); MIC = wm_pga (deja salvat)
    - limita de timp scoasă la cererea userului; emisie permisă pe toată banda HF
2026-10-21 Meniu: MIC continuu −17…+59 dB (boost + PGA), MIC SRC L+R / L / R (salvat)
    - MIC trece singur între boost 0/13/20/29 dB și PGA, fără salt de nivel:
    jos pentru semnal de linie (modul MAX4466), sus pentru electret / MEMS
    - MIC SRC alege canalul pentru emisie (microfon extern pe LINPUT1 în locul MIC2)
2026-10-21 Video nou (LSB 40 m, WM8960); butonul PTT (4,7 kΩ) în schema butoanelor și în docs
2026-10-22 README: scos „Emisia (TX) nu e implementată încă” — emisia funcționează
2026-10-22 README: tabel release-uri — v2.0 (WM8960, RX+TX) și v1.0 (PCM5102A, RX)
